Printopal/VoronDesign/Removable lateral panels and front doors + lockers/readme.md

3mm version use 3mm acrilic panels flush to 2020 extrusion frame.  

6mm version use 3mm acrilic panels + 3mm foam.

9mm version use 3mm acrilic panels + 6mm foam.

Please contact me if you need a custom thickness version.  

# Removable Lateral panels and front doors + lockers.
# OVERVIEW
This mod allow to get removable lateral panels and front doors. Side panels are maintained with lockers while front doors are maintained with magnets. Also, side panels and front doors are mounted on hinges and can simply be opened if it is not necessary to remove them.

Closed doors and panels  
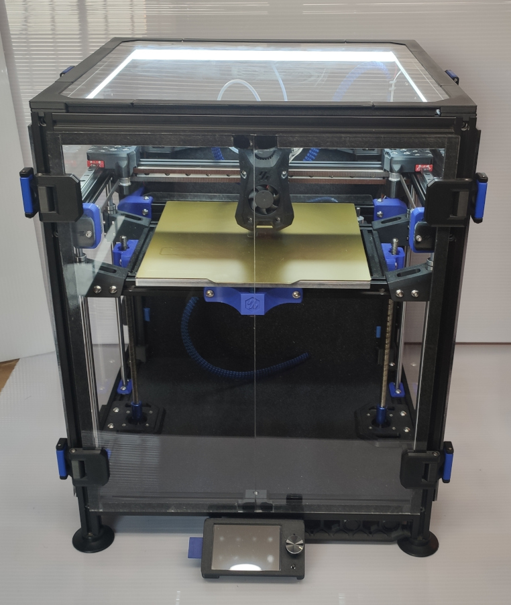
[picture p1: Removable lateral panels and front doors + lockers/Images/Closed_1.jpg]
Closed_1
  
Open doors and panels  
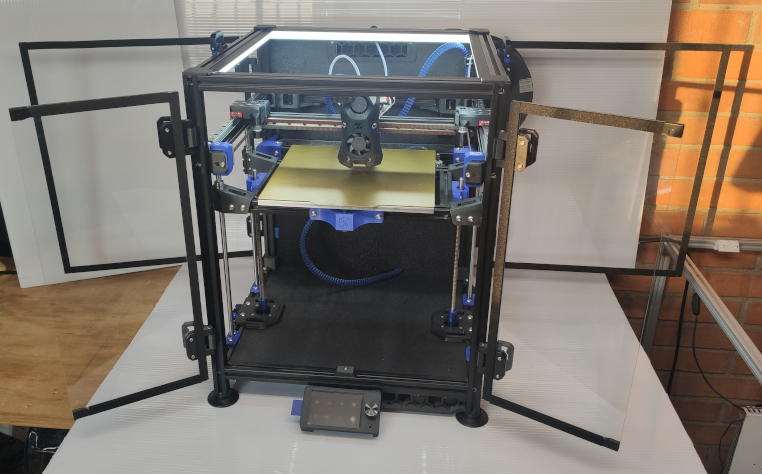
[picture p2: Removable lateral panels and front doors + lockers/Images/Open_1.jpg]
Open_1
  
Doors and panels removed  
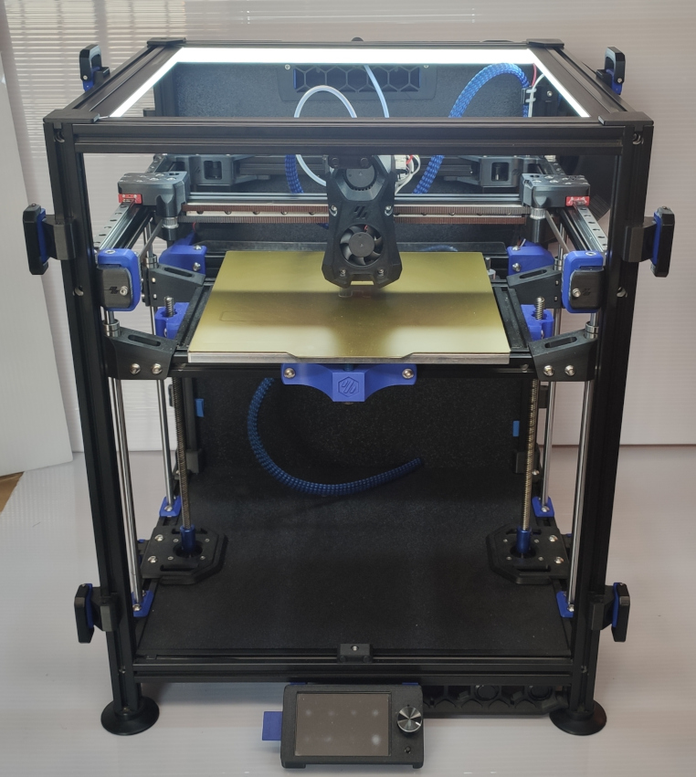
[picture p3: Removable lateral panels and front doors + lockers/Images/Removed_1.jpg]
Removed_1
  
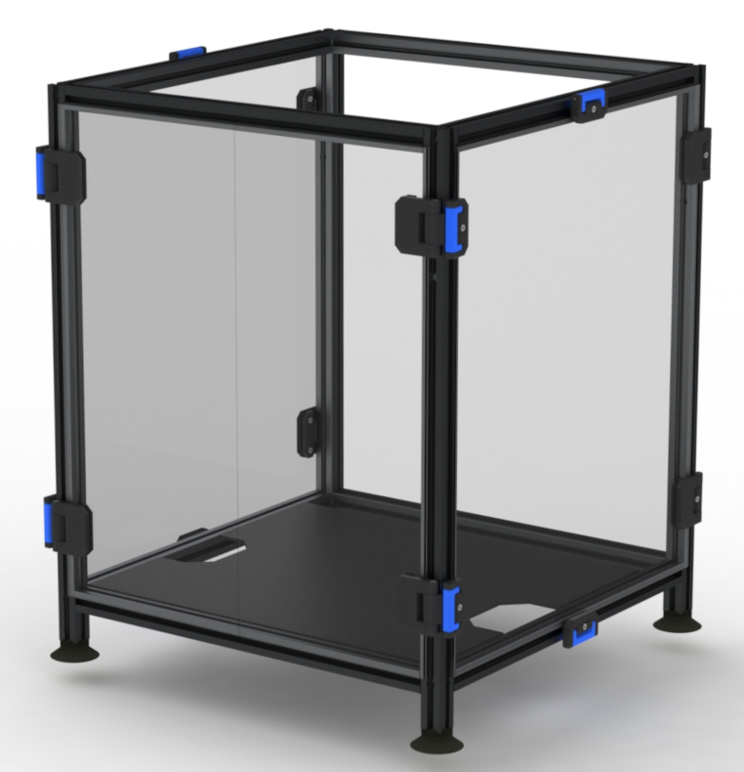
[picture p4: Removable lateral panels and front doors + lockers/Images/Enclosure.jpg]
Enclosure
  
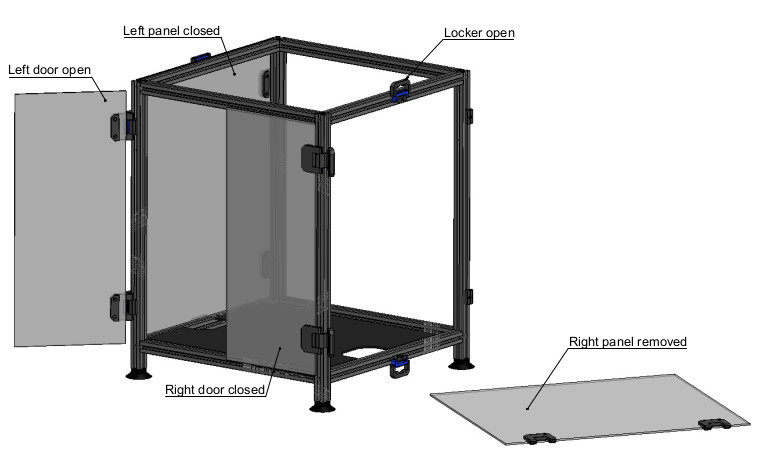
[picture p5: Removable lateral panels and front doors + lockers/Images/Description.jpg]
Description
  

# PANELS DIMENSIONS
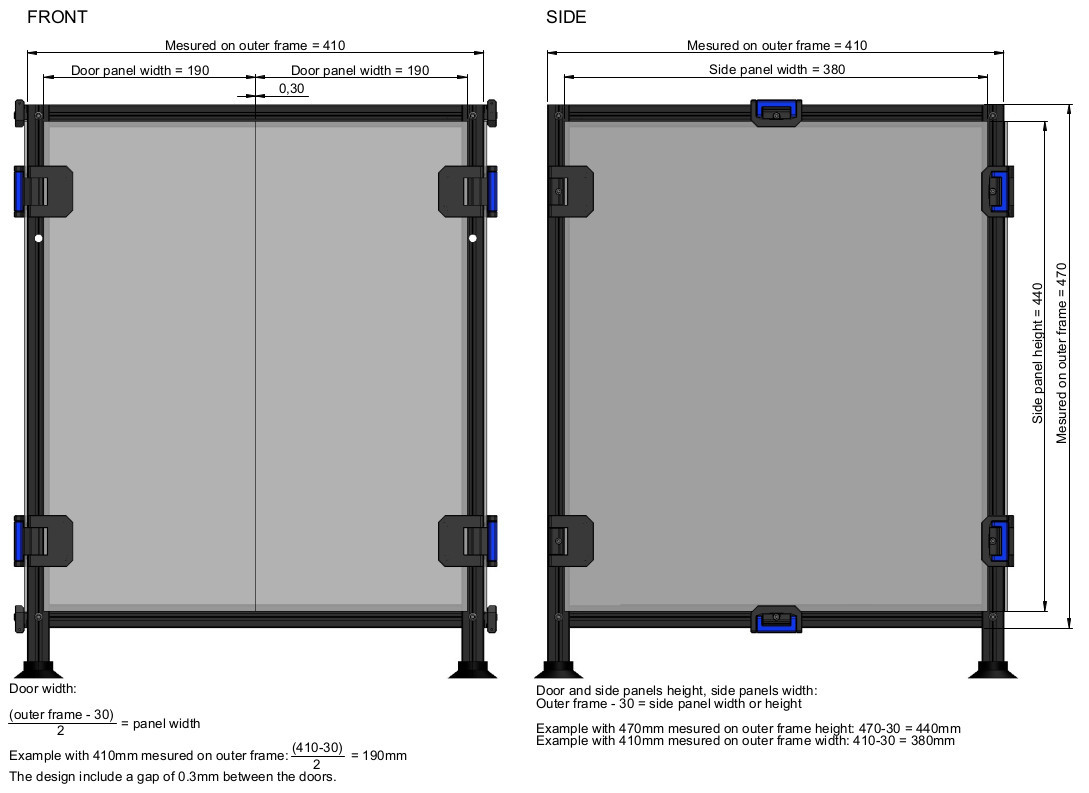
[picture p6: Removable lateral panels and front doors + lockers/Images/Panels_size.jpg]
Panels_size


Side panels and doors use the same cutout. units:mm  
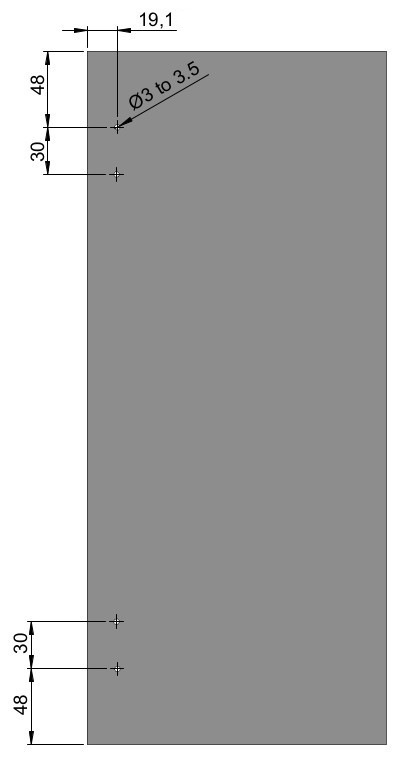
[picture p7: Removable lateral panels and front doors + lockers/Images/Panel_cut.jpg]
Panel_cut


BOM and Assembly details are in each version folder.
