Printopal/VoronDesign/Voron 1.8/Front idler AB/readme.md

# Front idler AB
# OVERVIEW
Modificacion of the front idlers to remove the gap that may appear.

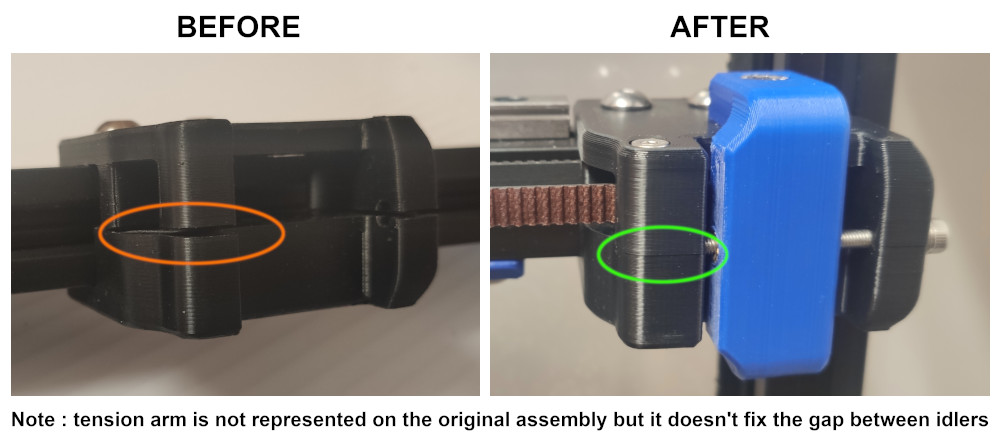
[picture p11: Voron 1.8/Front idler AB/Images/AB_front_comparison.jpg]
AB_front_comparison


# BOM
2x SHCS M3X25  
2x SHCS M3X35  
2x M3 Threaded insert short (those are the same used in the stock Voron BOM)

# DESCRIPTION
The tension stroke is slightly reduced from 28mm to 25mm. This allow to get enough wall thickness for the screw and insert.  
:warning: If your belts were flush mounted to your X carriage, then you will have to replace them for longer ones.

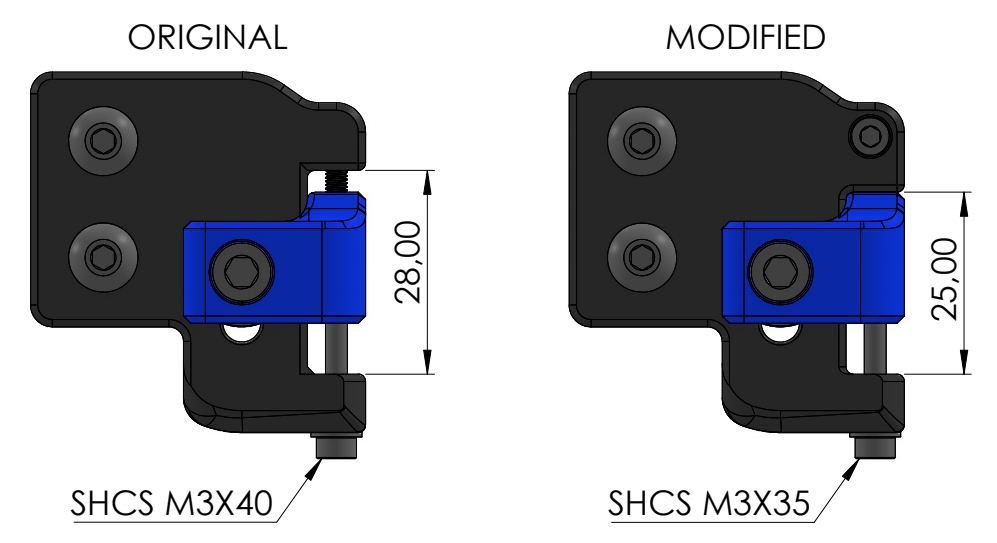
[picture p12: Voron 1.8/Front idler AB/Images/AB_Front_idler_changes.jpg]
AB_Front_idler_changes


# INSTRUCTIONS
1. Install heat set insert into the bottom A and B idler. Use and iron solder for this step.
2. Screw the M3x25 SHCS on top of A and B idler.
3. That is it! All that remain is in the stock assembly manual.

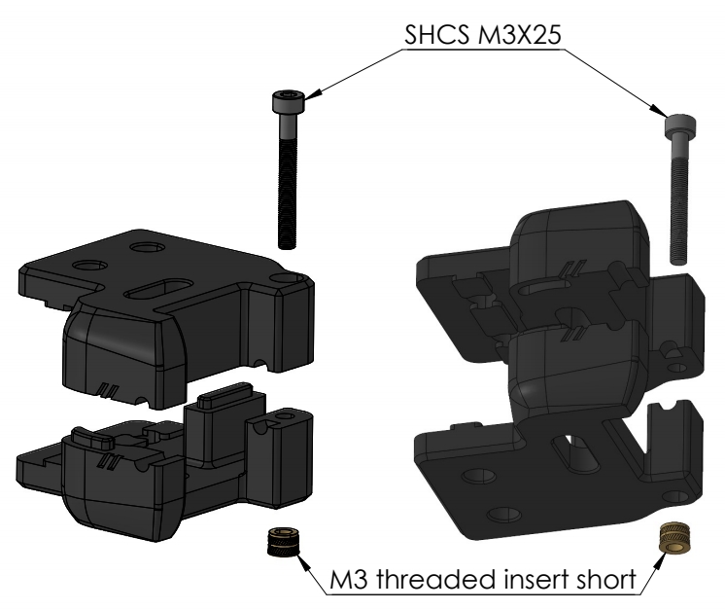
[picture p13: Voron 1.8/Front idler AB/Images/AB_front_idler_assembly.jpg]
AB_front_idler_assembly
