Printopal/VoronDesign/Removable lateral panels and front doors + lockers/9mm front doors and side panels/readme.md

This version is used for 3mm thick panels + 6mm foam.  
It allow to open the front door at 180°.

# DESCRIPTION
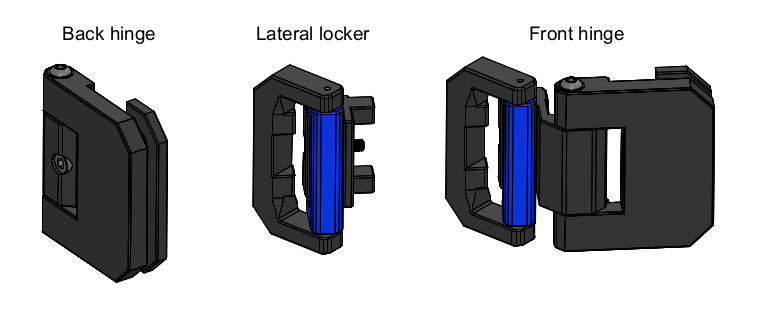
[picture p17: Removable lateral panels and front doors + lockers/9mm front doors and side panels/Images/Components.jpg]
Components
  
Lateral body locker and back hinge parts need support to be printed.

# BOM
8x SHCS M3x40  
8x BHCS M3x20  
4x SHCS M3x12  
16x SHCS M3x8  
8x T-slot nut M3  
4x Sliding T-nut M3  
16x Ø1.4x10 metallic pin or cut nails  
16x Ø1.4x20 metallic pin or cut nails  
4x Ø6x3mm neodymium magnet  

# ASSEMBLY
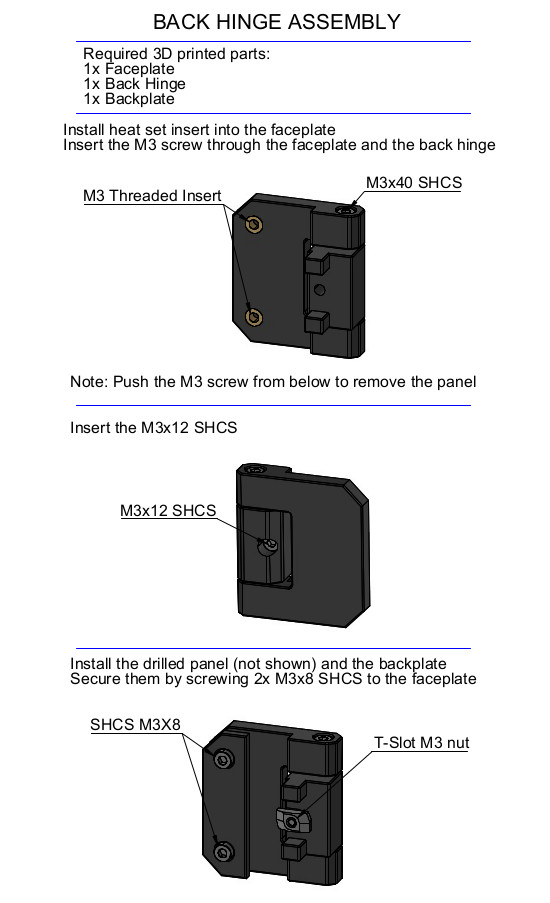
[picture p18: Removable lateral panels and front doors + lockers/9mm front doors and side panels/Images/Back_Hinge_Assembly_9mm.jpg]
Back Hinge Assembly 9mm

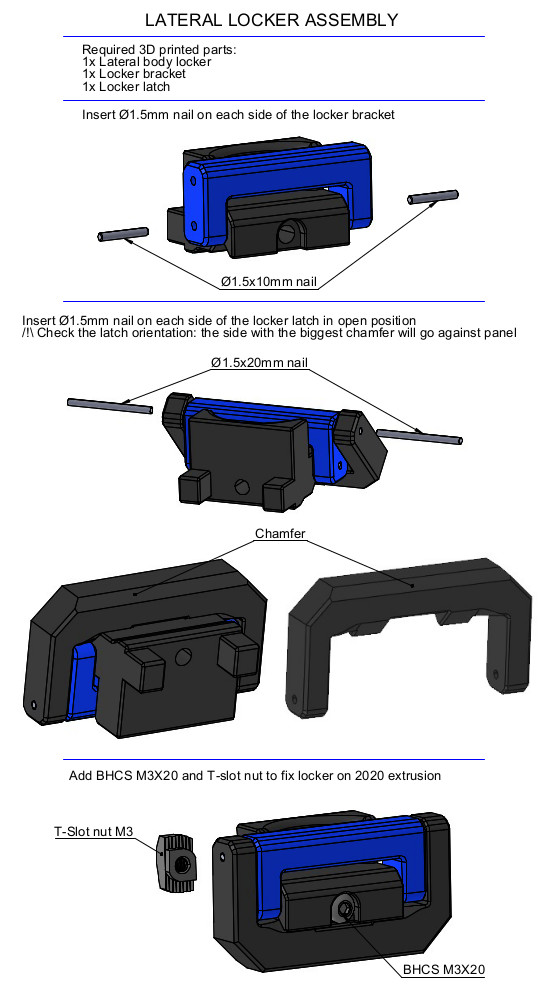
[picture p19: Removable lateral panels and front doors + lockers/9mm front doors and side panels/Images/Lateral_Locker_Assembly_9mm.jpg]
Lateral_Locker_Assembly_9mm

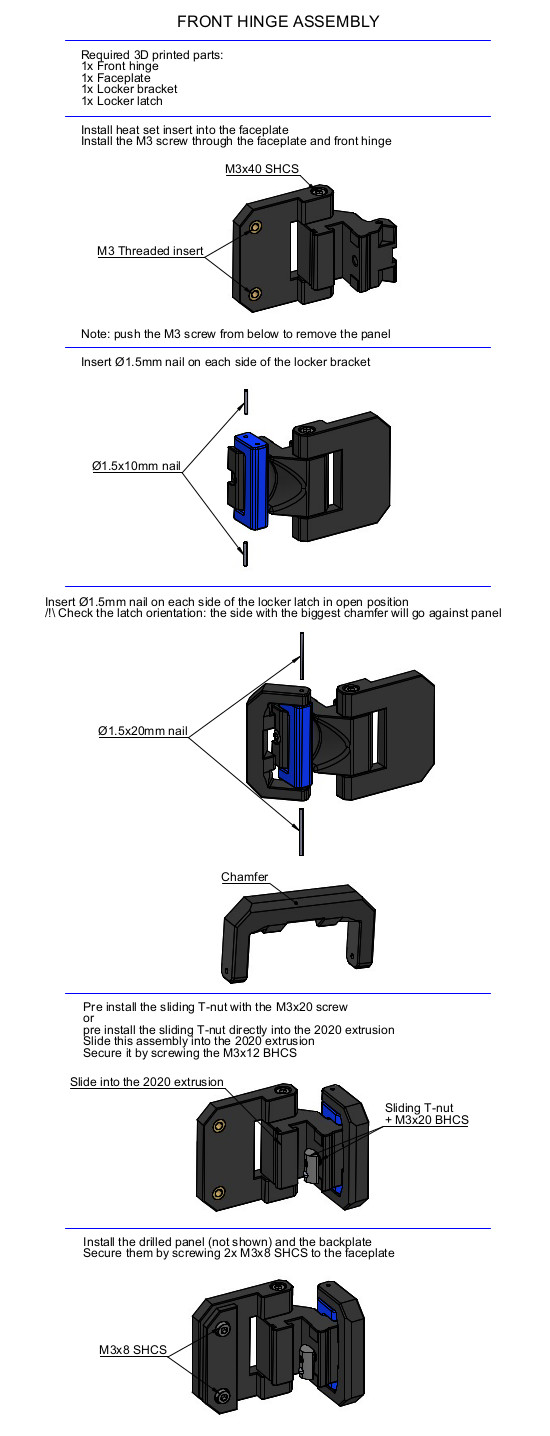
[picture p20: Removable lateral panels and front doors + lockers/9mm front doors and side panels/Images/Front_Hinge_Assembly_9mm.jpg]
Front_Hinge_Assembly_9mm
