Printopal/VoronDesign/Removable lateral panels and front doors + lockers/6mm front doors and side panels/readme.md

This version is used for 3mm thick panels + 3mm foam for side panels and front doors.  
It allow to open the front door at 165° MAX and the access to the locker bracket is a bit limited.

# DESCRIPTION
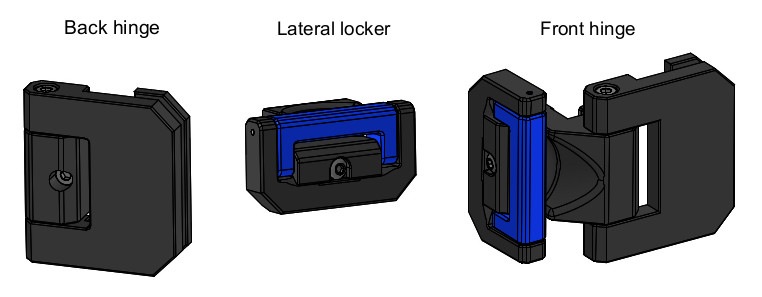
[picture p24: Removable lateral panels and front doors + lockers/6mm front doors and side panels/Images/Components.jpg]
Components
  
Lateral body locker and back hinge parts need support to be printed.

# BOM
8x SHCS M3x40  
8x SHCS M3x16  
4x SHCS M3x12  
16x SHCS M3x8  
8x T-slot nut M3  
4x Sliding T-nut M3  
16x Ø1.4x10 metallic pin or cut nails  
16x Ø1.4x20 metallic pin or cut nails  

# ASSEMBLY
Back Hinge Assembly 6mm
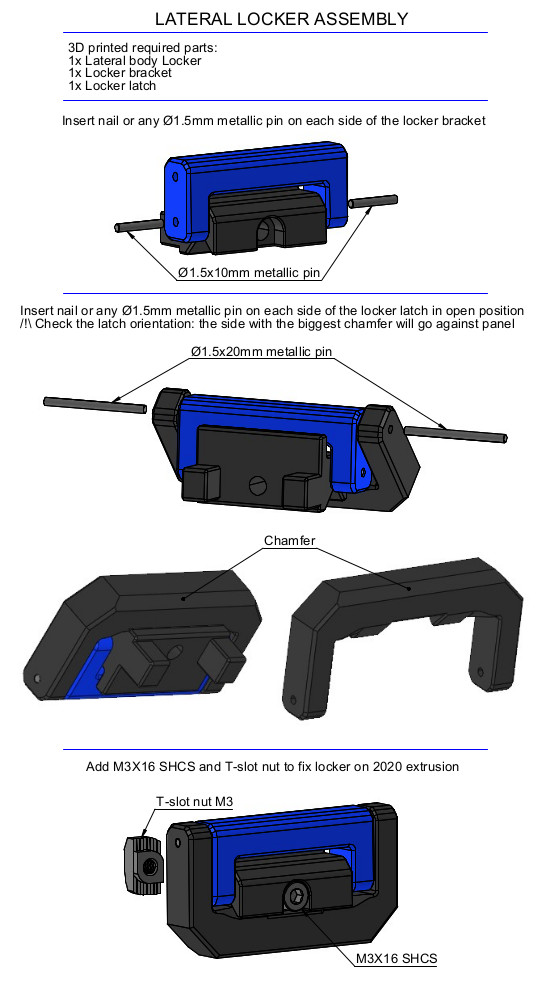
[picture p25: Removable lateral panels and front doors + lockers/6mm front doors and side panels/Images/Lateral_locker_Assembly_6mm.jpg]
Lateral_Locker_Assembly_6mm

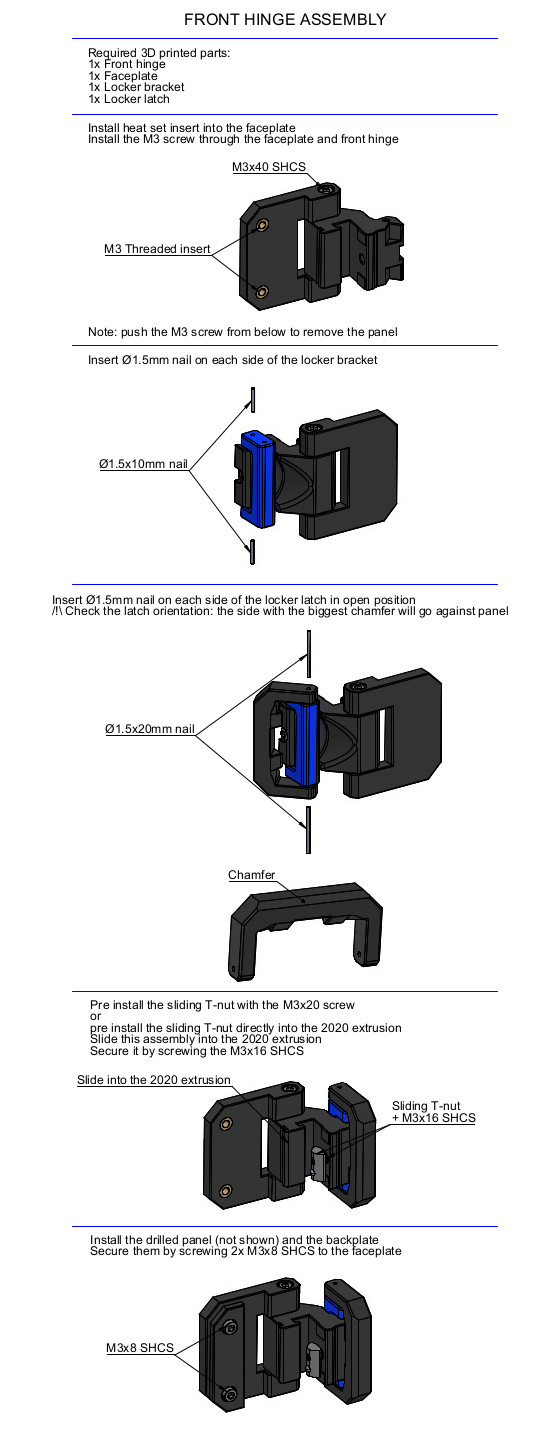
[picture p26: Removable lateral panels and front doors + lockers/6mm front doors and side panels/Images/Front_Hinge_Assembly_6mm.jpg]
Front_Hinge_Assembly_6mm
