Printopal/VoronDesign/Removable lateral panels and front doors + lockers/3mm front doors and side panels/STL/back_hinge_3mm_x4.stl

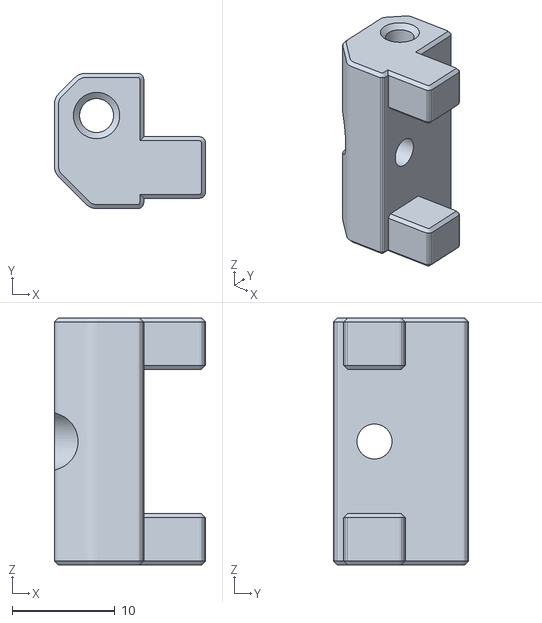
[picture p27: CAD file, 2022-02-16]
Removable lateral panels and front doors + lockers/3mm front doors and side panels/STL/back_hinge_3mm_x4.stl
14.7 x 13.1 x 24.0
