Printopal/VoronDesign/Removable lateral panels and front doors + lockers/6mm front doors and side panels/STL/door_locker_B_6mm_x2.stl

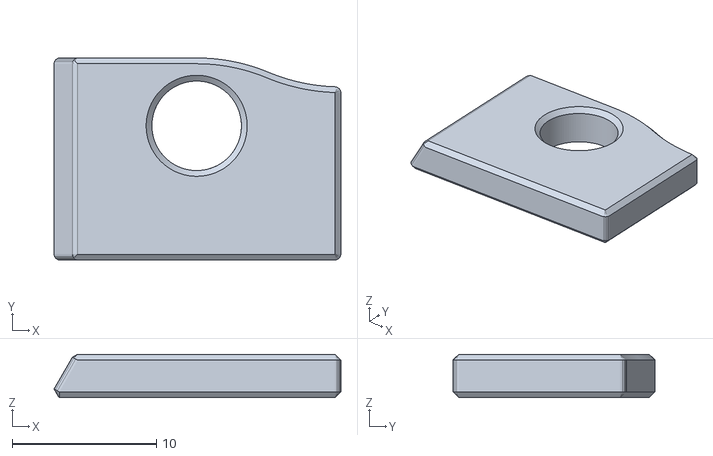
[picture p28: CAD file, 2022-02-28]
Removable lateral panels and front doors + lockers/6mm front doors and side panels/STL/door_locker_B_6mm_x2.stl
19.9 x 14.0 x 3.00
