Printopal/VoronDesign/Removable lateral panels and front doors + lockers/9mm front doors and side panels/STL/door_locker_B_9mm_x2.stl

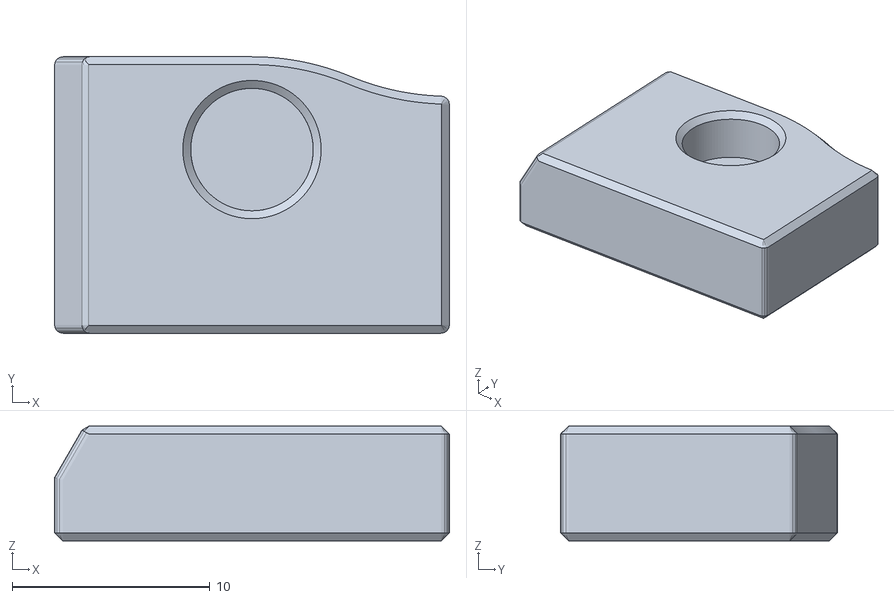
[picture p29: CAD file, 2022-02-28]
Removable lateral panels and front doors + lockers/9mm front doors and side panels/STL/door_locker_B_9mm_x2.stl
20.0 x 14.0 x 5.80
