Printopal/VoronDesign/Removable lateral panels and front doors + lockers/3mm front doors and side panels/STL/locker_latch_3mm_x8.stl

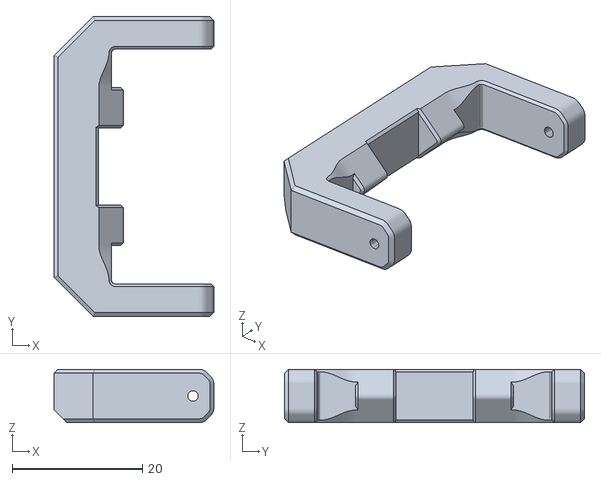
[picture p30: CAD file, 2022-02-16]
Removable lateral panels and front doors + lockers/3mm front doors and side panels/STL/locker_latch_3mm_x8.stl
24.5 x 46.0 x 8.20
