Printopal/VoronDesign/Removable lateral panels and front doors + lockers/3mm front doors and side panels/STL/lateral_body_locker_3mm_x4.stl

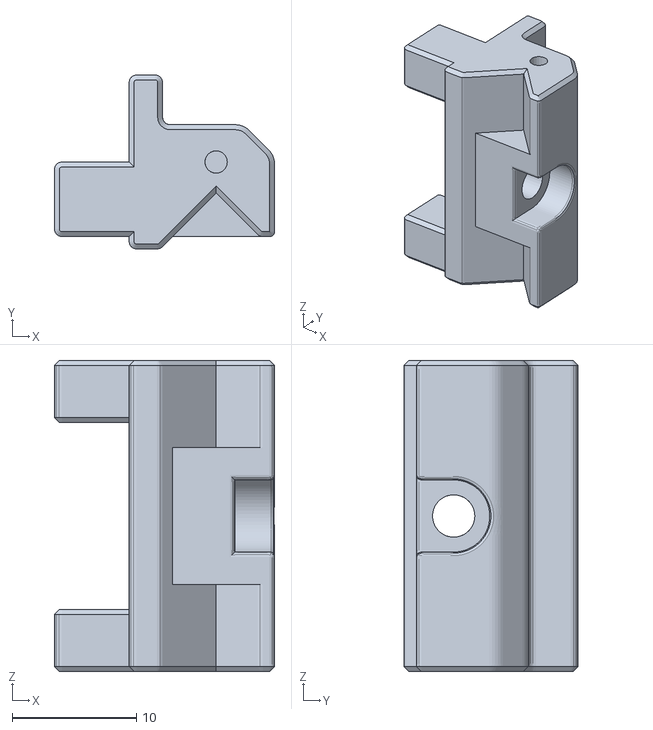
[picture p31: CAD file, 2022-02-16]
Removable lateral panels and front doors + lockers/3mm front doors and side panels/STL/lateral_body_locker_3mm_x4.stl
17.7 x 14.0 x 25.0
