Printopal/VoronDesign/Removable lateral panels and front doors + lockers/6mm front doors and side panels/STL/[a]_locker_bracket_6mm_x8.stl

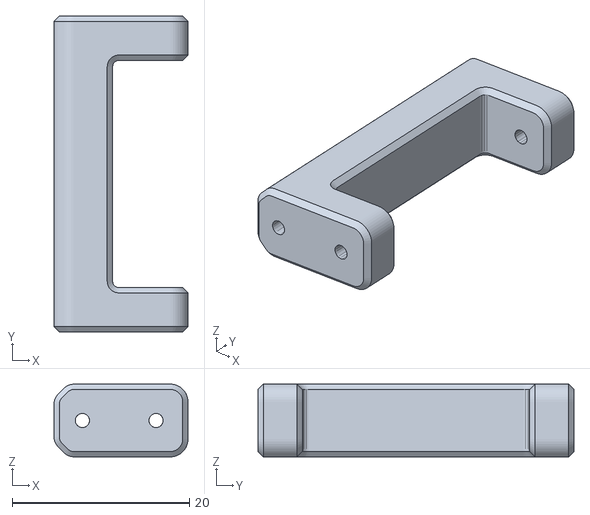
[picture p32: CAD file, 2022-02-28]
Removable lateral panels and front doors + lockers/6mm front doors and side panels/STL/[a]_locker_bracket_6mm_x8.stl
15.1 x 35.6 x 8.20
