Printopal/VoronDesign/Removable lateral panels and front doors + lockers/9mm front doors and side panels/STL/doorstep.stl

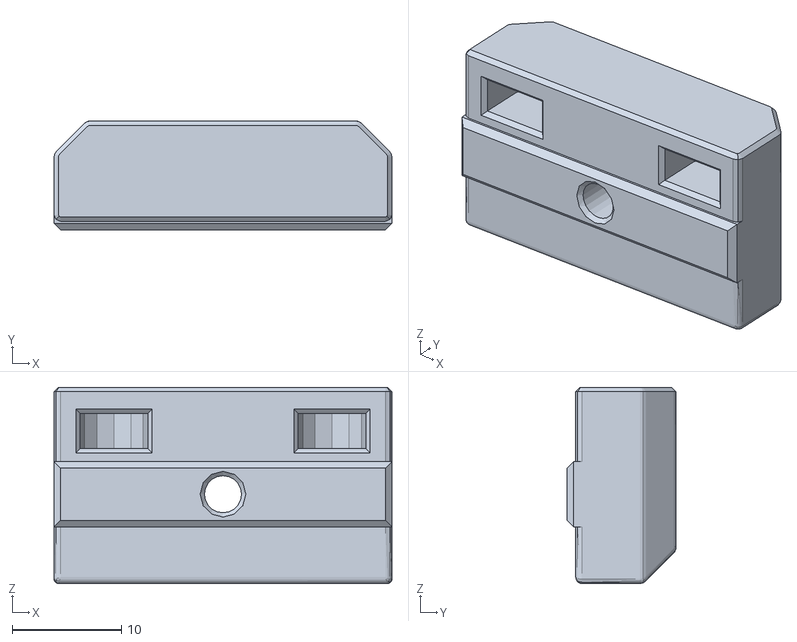
[picture p33: CAD file, 2022-02-28]
Removable lateral panels and front doors + lockers/9mm front doors and side panels/STL/doorstep.stl
31.0 x 10.0 x 18.0
