Printopal/VoronDesign/Removable lateral panels and front doors + lockers/3mm front doors and side panels/STL/backplate_x8.stl

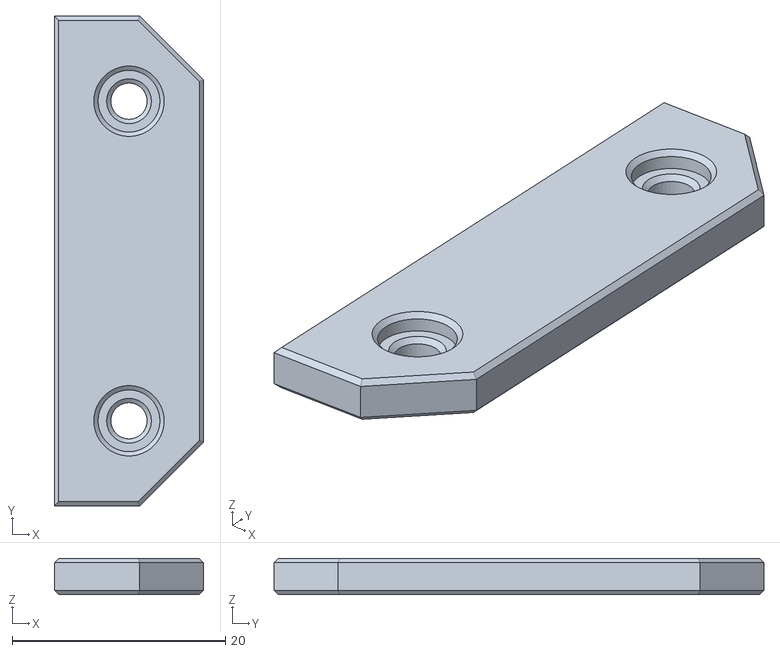
[picture p34: CAD file, 2022-02-16]
Removable lateral panels and front doors + lockers/3mm front doors and side panels/STL/backplate_x8.stl
14.0 x 46.0 x 3.40
