Printopal/VoronDesign/Removable lateral panels and front doors + lockers/9mm front doors and side panels/STL/back_hinge_9mm_x4.stl

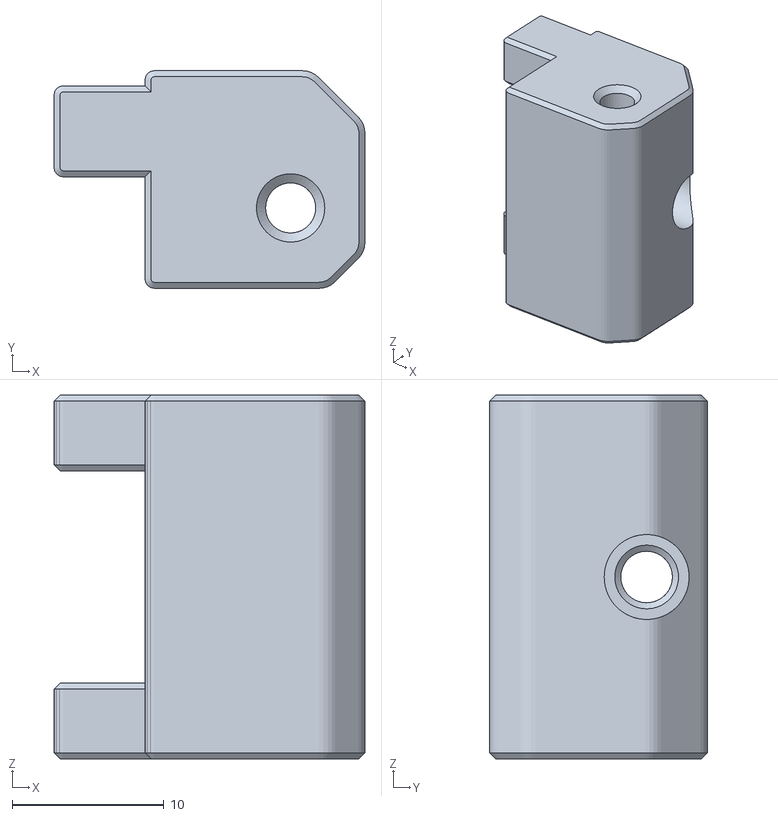
[picture p35: CAD file, 2022-02-21]
Removable lateral panels and front doors + lockers/9mm front doors and side panels/STL/back_hinge_9mm_x4.stl
20.5 x 14.4 x 24.0
