Printopal/VoronDesign/Removable lateral panels and front doors + lockers/9mm front doors and side panels/STL/lateral_body_locker_9mm_x4.stl

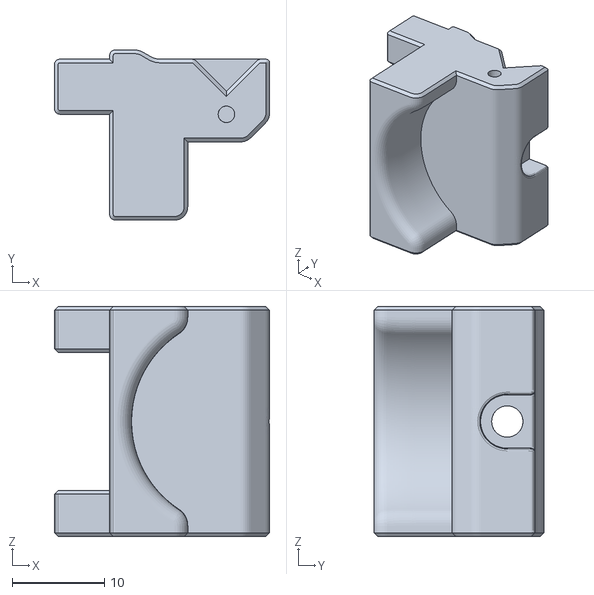
[picture p36: CAD file, 2022-02-21]
Removable lateral panels and front doors + lockers/9mm front doors and side panels/STL/lateral_body_locker_9mm_x4.stl
23.4 x 18.5 x 25.0
