Printopal/VoronDesign/(list of files, cad)

Other CAD files:
Magnetic top panel/STEP/250_top_panel_asm.stp
Magnetic top panel/STEP/top_corner_skirt.stp
Voron 1.8/Front idler AB/STEP/front_idler_top_a.stp
Magnetic top panel/STEP/panel_corner.stp
Removable lateral panels and front doors + lockers/6mm front doors and side panels/STL/door_locker_A_6mm_x2.stl
Removable lateral panels and front doors + lockers/9mm front doors and side panels/STL/door_locker_A_9mm_x2.stl
Voron 1.8/Front idler AB/STEP/front_idler_bottom_a.stp
Magnetic top panel/STEP/frame_corner.stp
Voron 1.8/Front idler AB/STEP/front_idler_bottom_b.stp
Magnetic top panel/STEP/350_top_skirt_320.stp
Voron 1.8/Front idler AB/STEP/front_idler_top_b.stp
Magnetic top panel/STEP/300_top_skirt_270.stp
Removable lateral panels and front doors + lockers/3mm front doors and side panels/STL/[a]_locker_bracket_3mm_x8.stl
Magnetic top panel/STEP/250_top_skirt_220.stp
Magnetic top panel/STL/250_top_skirt_220.stl
Magnetic top panel/STL/300_top_skirt_270.stl
Magnetic top panel/STL/350_top_skirt_320.stl
Magnetic top panel/STL/frame_corner.stl
Magnetic top panel/STL/panel_corner.stl
Magnetic top panel/STL/top_corner_skirt.stl
