Printopal/VoronDesign/(threads)

Thread 1 (2022-05-13):

X axis MGN12

DiamonBlu, 2022-05-13:
hi, do you have the file X axis MGN12 yet?

Printopal, 2022-05-13:
Hi, thanks for asking. It's not available yet! I plan to modifiy the X carriage and install an Omron probe instead of the actual PL-08. The reason i am not sharing those files is i am getting overheating on that area and don't want to share anything until I solve this. Right now I don't have any time for this but I expect to get everything functional in august.
BTW if you already have an Omron probe, I think the X carriage files provided with the Trident should work and in that case I can share you the XY joints files.

DiamonBlu, 2022-05-15:
oh yes, i will need the xy file, thanks so much 🤗

Printopal, 2022-05-15:
Alright, I created an OBJ folder and uploaded the XY joints files.

Keep in mind they are designed for Gates Idler that are 10 mm tall.
You will need to add some few supports for the PCB clearance of xy_joint_right_lower.
You will also need to add some few supports for 1 M5 nut hole of xy_joint_right_lower, I decided to remove the chamfer of that M5 nut hole to have more thickness in Z.

Don't hesitate to give me your feedback :+1:
Happy printing!

DiamonBlu, 2022-05-16:
yes, definitely, but i can't download the file, does it look like the file is corrupted or i didn't download it properly? can you check again?
