Printopal/VoronDesign/(commit log)

2021-06-05 Create Magnetic_top_panel
2021-06-05 Create Magnetic
2021-06-09 Create stl
2022-02-03 Create Front idler AB
2022-02-16 Create 3mm
2022-02-16 Rename Lateral panels lockers + Doors/3mm panels/readme.md to Removable lateral panels and front doors + lockers/3mm panels/readme.md
2022-02-16 Rename Removable lateral panels and front doors + lockers/3mm panels/readme.md to Removable lateral panels and front doors + lockers/3mm panels/images/img
2022-02-21 Rename Removable lateral panels and front doors + lockers/9mm/Images/readme.md to Removable lateral panels and front doors + lockers/9mm : 3mm panels + 6mm foam/Images/readme.md
2022-02-28 Rename Removable lateral panels and front doors + lockers/9mm : 3mm panels + 6mm foam/readme.md to Removable lateral panels and front doors + lockers/9mm front doors and side panels/readme.md
2022-02-28 Rename Removable lateral panels and front doors + lockers/3mm panels/readme.md to Removable lateral panels and front doors + lockers/3mm front doors and side panels/readme.md
2022-05-15 Rename Voron 1.8/X axis MGN12/readme.md to Voron 1.8/X axis MGN12/OBJ/o
